alfredzhang98/GripperOne/source_files/imu_JY901P_uart/README.md

# SDK UART user manual

[link](https://wit-motion.yuque.com/wumwnr/ltst03/vl3tpy?)
