alfredzhang98/GripperOne/hardware/bom/BOM.en.md

[中文](BOM.md) | **English**

# Bill of Materials (BOM)

One gripper can be built for about **CNY 3000 (about USD 420)**, of which the PaXini tactile sensors are about CNY 1500. Excel version: [BOM.xlsx](BOM.xlsx); it matches this page, so update both together.

 Lead screw and nut supplier: [Fanzhan Metal Products (繁展金属制品有限公司)](https://shop213748648.taobao.com) on Taobao.

| No. | Category | Name | Image | Spec / Model | Qty | Process / Material | Source / Link | CAD file | Notes |
| --- | --- | --- | --- | --- | --- | --- | --- | --- | --- |
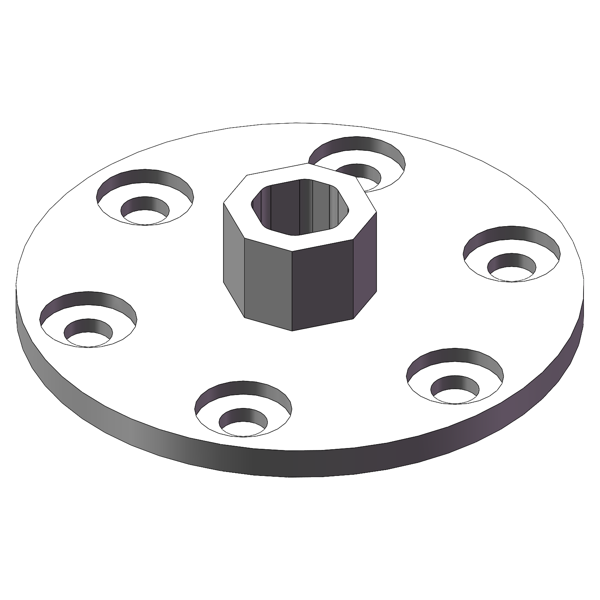
[picture p2: hardware/bom/img/01_rotor_to_lead_screw_coupler.png]
| 1 | Structural parts | Rotor-to-lead-screw coupler |  |  | 1 | CNC | Quanzhou CNC (铨洲) | 转子丝杆传动件 |  |
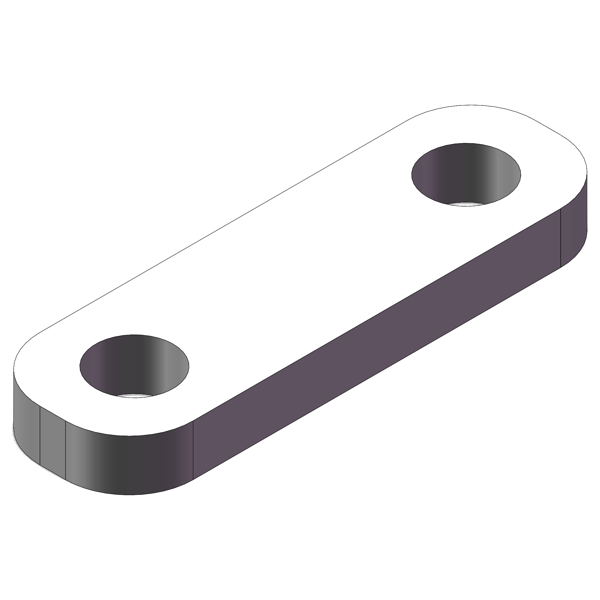
[picture p3: hardware/bom/img/02_nut_link.png]
| 2 | Structural parts | Nut link |  | SS304 | 4 | CNC | Quanzhou CNC (铨洲) | 螺母连杆 | Highly loaded; use SS304 |
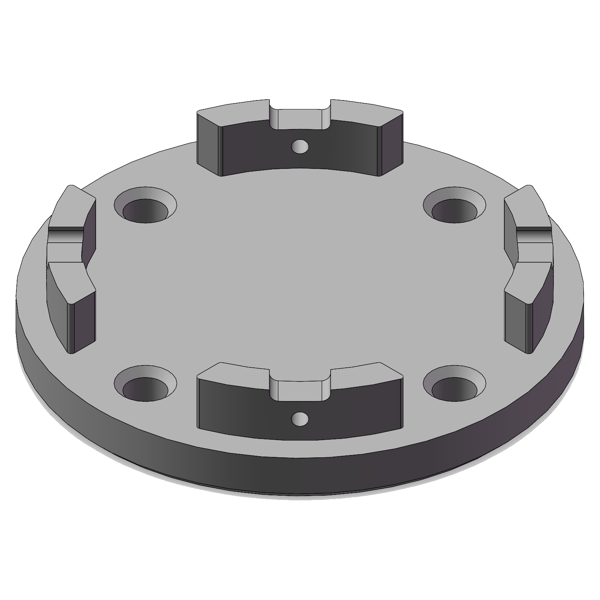
[picture p4: hardware/bom/img/03_bottom_cover.png]
| 3 | Structural parts | Bottom cover |  |  | 1 | 3D print (PETG) |  | urconnector | Avoid resin (SLA) prints: heat-set inserts do not bond well in resin |
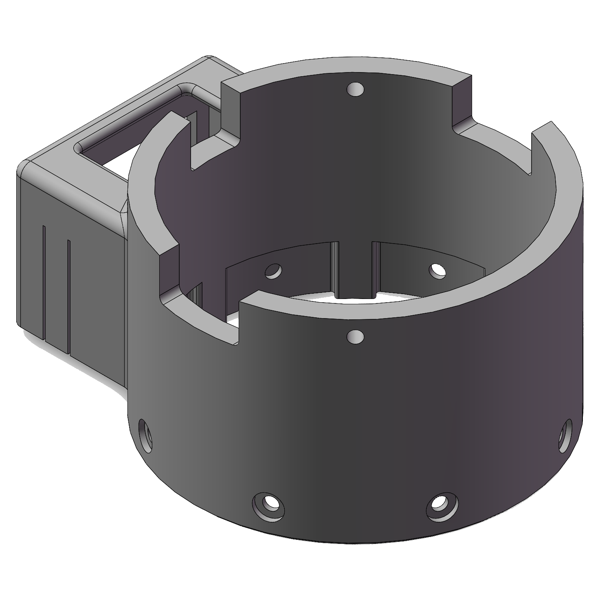
[picture p5: hardware/bom/img/04_motor_housing.png]
| 4 | Structural parts | Motor housing |  |  | 1 | 3D print (PETG) |  | motor_out | Avoid resin (SLA) prints: heat-set inserts do not bond well in resin |
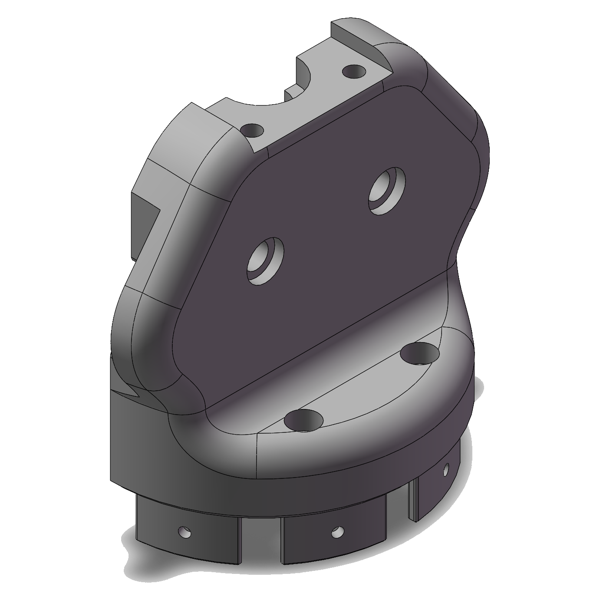
[picture p6: hardware/bom/img/05_main_housing.png]
| 5 | Structural parts | Main housing |  |  | 2 | 3D print (PETG) |  | 外壳 | Avoid resin (SLA) prints: heat-set inserts do not bond well in resin |
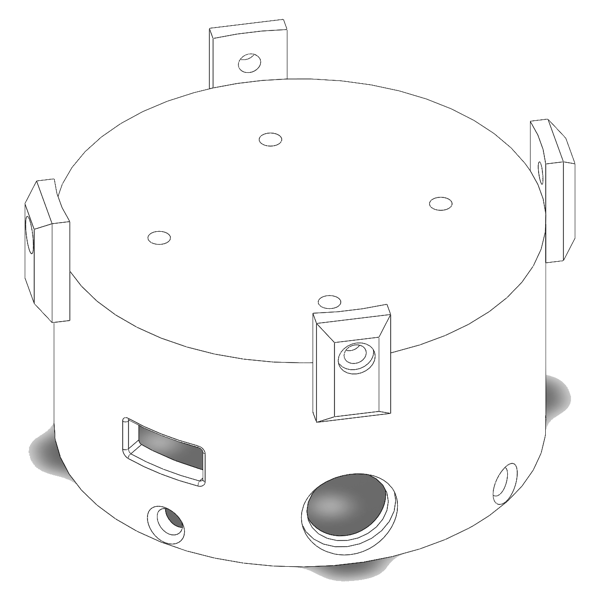
[picture p7: hardware/bom/img/06_electronics_bay_housing.png]
| 6 | Structural parts | Electronics bay housing |  |  | 1 | CNC |  | upper | New in this design: holds the main PCB, side opening for USB |
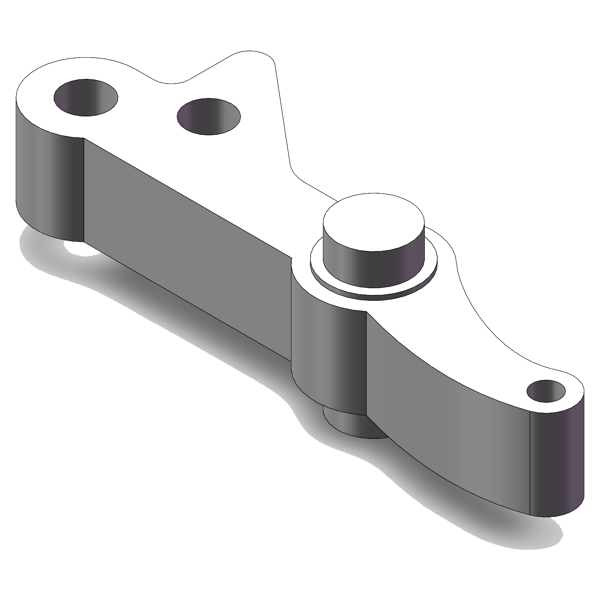
[picture p8: hardware/bom/img/07_driving_link.png]
| 7 | Structural parts | Driving link |  |  | 2 | CNC | Quanzhou CNC (铨洲) | 主动杆 |  |
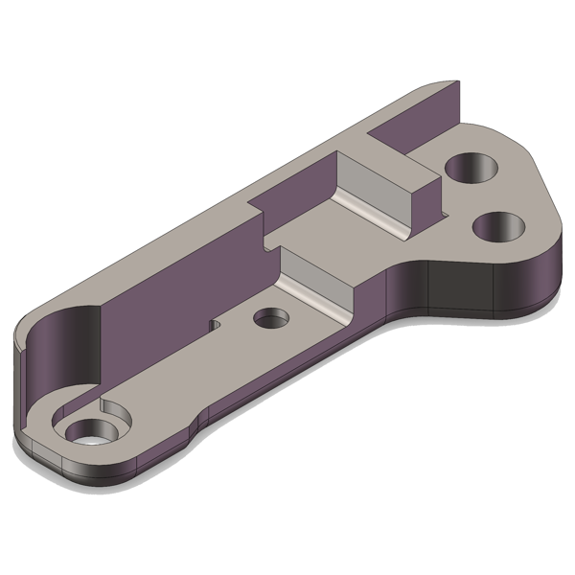
[picture p9: hardware/bom/img/08_underactuated_link.png]
| 8 | Structural parts | Underactuated link |  |  | 2 | CNC | Quanzhou CNC (铨洲) | 镜向欠驱动杆 |  |
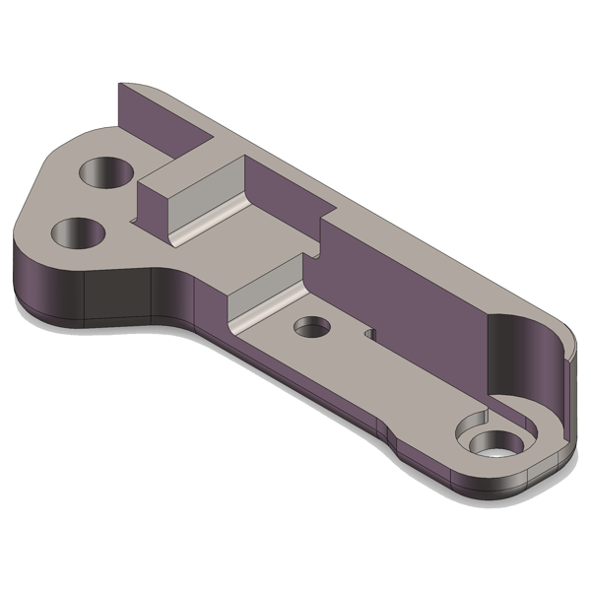
[picture p10: hardware/bom/img/09_underactuated_link_mirrored.png]
| 9 | Structural parts | Underactuated link, mirrored |  |  | 2 | CNC | Quanzhou CNC (铨洲) | 镜向欠驱动杆-镜像 |  |
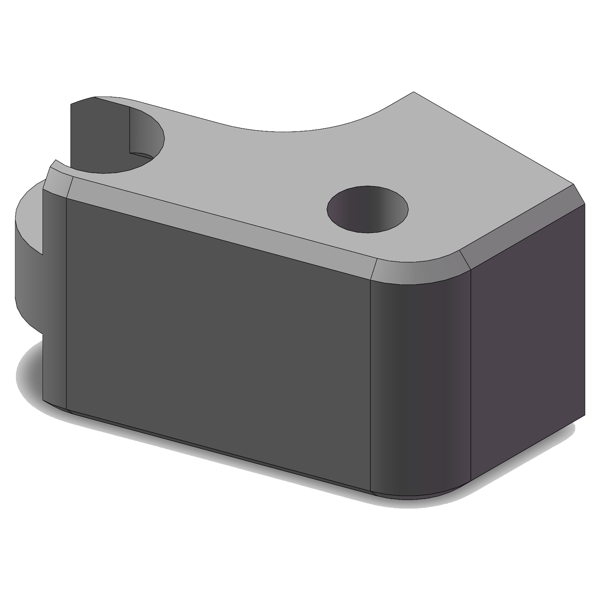
[picture p11: hardware/bom/img/10_finger_link.png]
| 10 | Structural parts | Finger link |  |  | 2 | 3D print (PETG) |  | 手指连杆 | Avoid resin (SLA) prints: heat-set inserts do not bond well in resin |
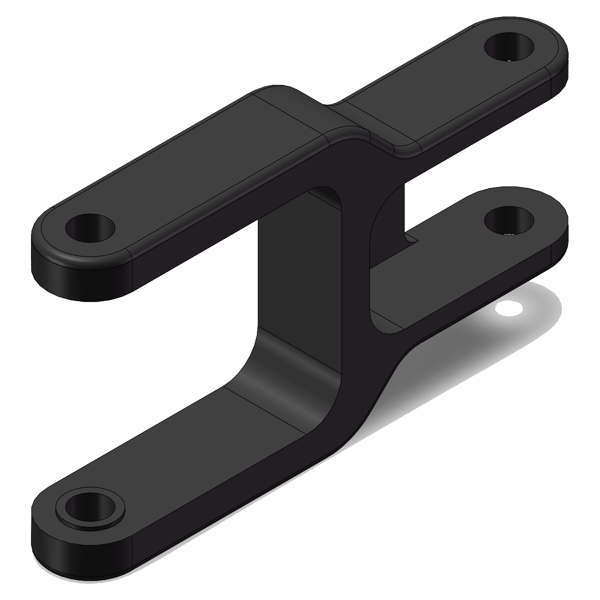
[picture p12: hardware/bom/img/11_driven_link.png]
| 11 | Structural parts | Driven link |  |  | 2 | CNC | Quanzhou CNC (铨洲) | 从动杆 |  |
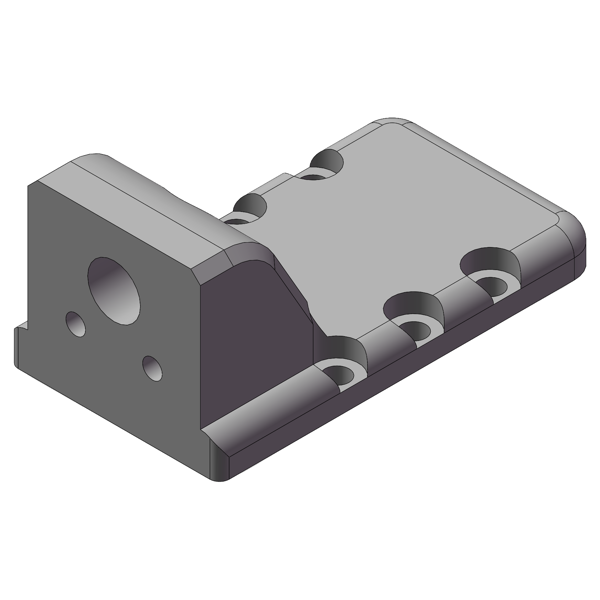
[picture p13: hardware/bom/img/12_finger.png]
| 12 | Structural parts | Finger |  |  | 2 | 3D print (PETG) |  | 手指v2 | Avoid resin (SLA) prints: heat-set inserts do not bond well in resin |
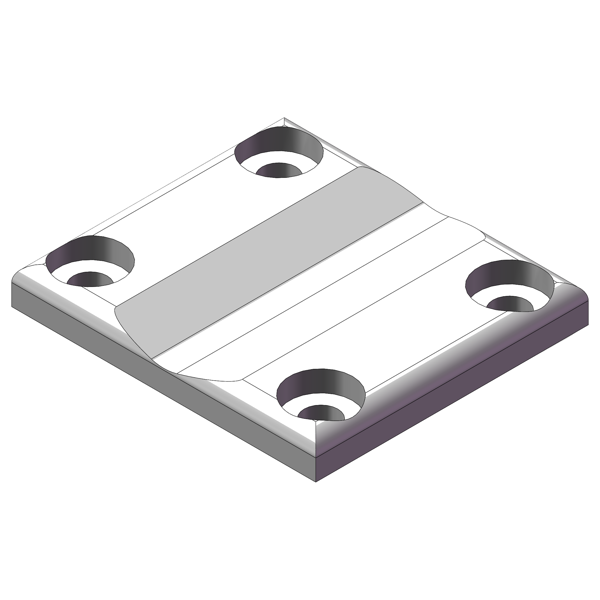
[picture p14: hardware/bom/img/13_end_cap.png]
| 13 | Structural parts | End cap |  |  | 1 | 3D print (PETG) |  | 挡盖 | Avoid resin (SLA) prints: heat-set inserts do not bond well in resin |
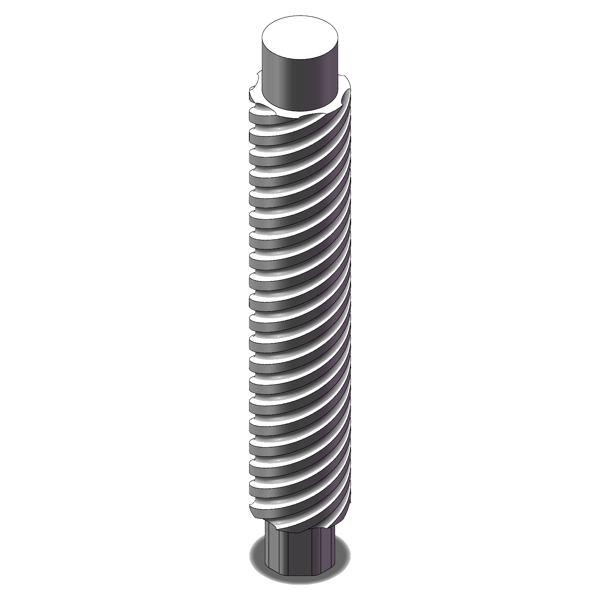
[picture p15: hardware/bom/img/14_lead_screw.png]
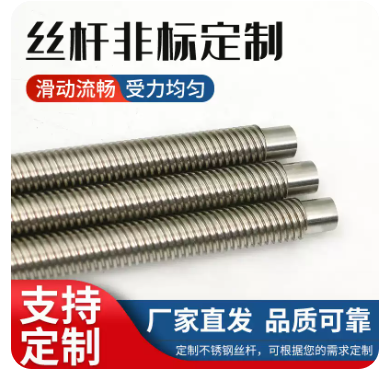
[picture p16: hardware/bom/img/14_lead_screw_shop.png]
| 14 | Drive train | Lead screw |   | SS304 T8×2 trapezoidal screw; the order link's variant shows "left/right-hand T8×2×200 mm + 2 nuts", please verify | 1 | Custom length / end machining | [Fanzhan Metal (Taobao)](https://item.taobao.com/item.htm?id=719659221034&skuId=5016268544734) | 丝杆 | Recommend switching to a standard part, see Suggestions |
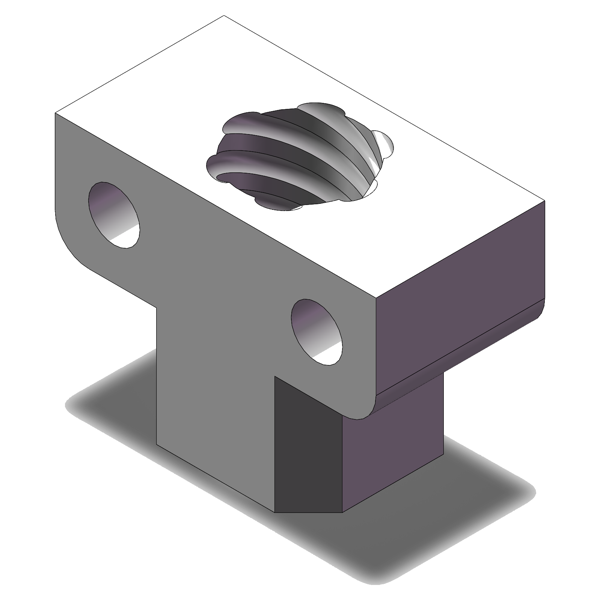
[picture p17: hardware/bom/img/15_lead_screw_nut.png]
| 15 | Drive train | Lead screw nut |  | T8×2 brass nut | 1 | Brass | [Fanzhan Metal (Taobao)](https://item.taobao.com/item.htm?id=719659221034&skuId=5016268544734) | 丝杆螺母 | Same shop as the screw; recommend a standard brass flange nut |
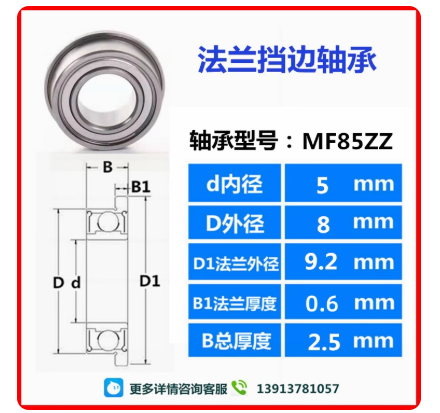
[picture p18: hardware/bom/img/16_small_flanged_bearing.png]
| 16 | Bearings | Small flanged bearing |  | MF85ZZ (5×8×9.2×0.6×2.5) | 4 |  | [Taobao](https://item.taobao.com/item.htm?id=627537372468) |  |  |
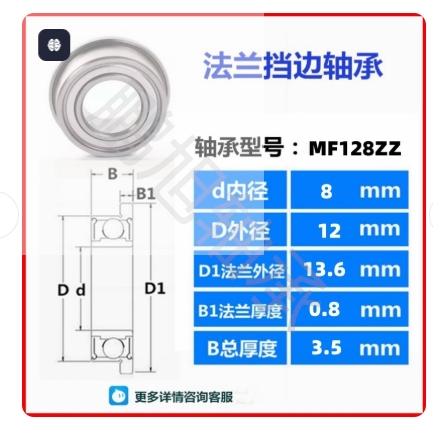
[picture p19: hardware/bom/img/17_flanged_bearing.png]
| 17 | Bearings | Flanged bearing |  | MF128ZZ (8×12×13.6×0.8×3.5) | 4 |  | [Taobao (same shop)](https://item.taobao.com/item.htm?id=627537372468) |  |  |
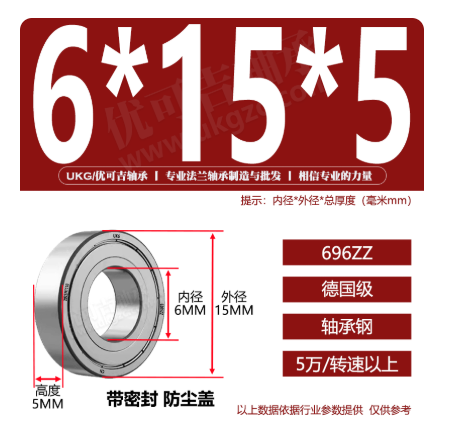
[picture p20: hardware/bom/img/18_deep_groove_ball_bearing.png]
| 18 | Bearings | Deep-groove ball bearing |  | 6×15×5, sealed | 1 |  | [Tmall](https://detail.tmall.com/item.htm?id=735576032715) | 轴承5_15_5 | CAD file says 5×15×5 but BOM says 6×15×5; check the bore |
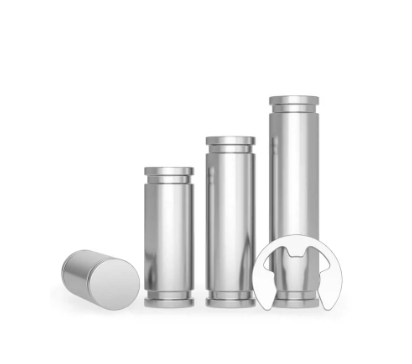
[picture p21: hardware/bom/img/19_grooved_pin_with_circlips.png]
| 19 | Fasteners, pins & springs | Grooved pin with circlips |  | M5×30 (Ø5 × 30 mm) | 6 |  | [Tmall](https://detail.tmall.com/item.htm?id=617648776883&skuId=5533509412784) |  |  |
| 20 | Fasteners, pins & springs | Grooved pin with circlips |  | M5×45 (Ø5 × 45 mm) | 2 |  | [Tmall (same item)](https://detail.tmall.com/item.htm?id=617648776883) | 双头卡簧销轴m5-45 |  |
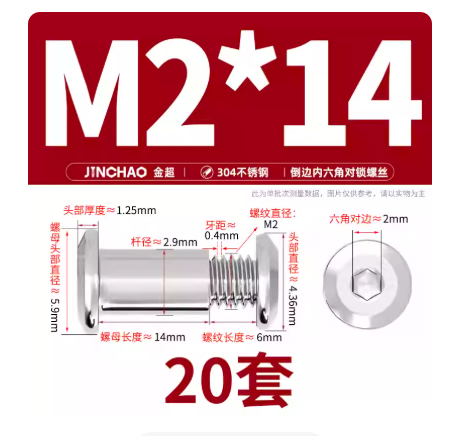
[picture p22: hardware/bom/img/21_binding_screw_chicago_screw.png]
| 21 | Fasteners, pins & springs | Binding screw (Chicago screw) |  | M2×14 | 4 |  | [Tmall](https://detail.tmall.com/item.htm?id=738916254976) |  | Pack of 20 sets |
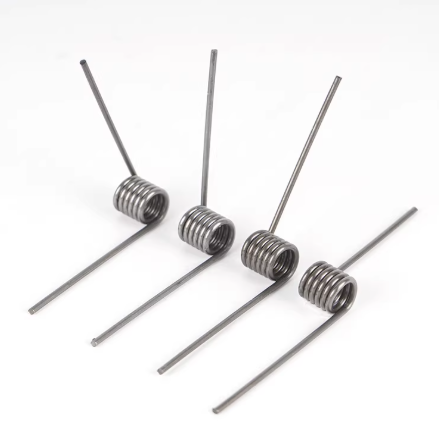
[picture p23: hardware/bom/img/22_torsion_spring.png]
| 22 | Fasteners, pins & springs | Torsion spring |  | Wire 1.2, OD 7.5, 5 coils, 180° | 2 |  | [Tmall](https://detail.tmall.com/item.htm?id=774983364150) |  | 1 left-hand + 1 right-hand (pack of 10) |
| 23 | Fasteners, pins & springs | Socket head cap screw |  | M5×6, ISO 4762 | TBD |  |  |  |  |
| 24 | Fasteners, pins & springs | Socket head cap screw |  | M3×6, ISO 4762 | TBD |  |  |  |  |
| 25 | Fasteners, pins & springs | Socket head cap screw |  | M3×5, ISO 4762 | TBD |  |  |  |  |
| 26 | Fasteners, pins & springs | Low-profile (wafer) head screw |  | M2.5×3 | TBD |  |  |  |  |
| 27 | Fasteners, pins & springs | Socket countersunk screw |  | M3×6, ISO 10642 | TBD |  |  |  |  |
| 28 | Fasteners, pins & springs | Heat-set insert |  | TBD | TBD |  |  |  | Missing from the original BOM, needed by the printed parts |
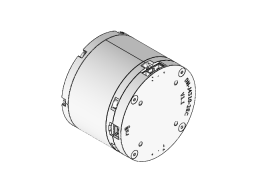
[picture p24: hardware/bom/img/29_joint_motor.png]
| 29 | Actuator | Joint motor |  | Damiao DM-J4310-2EC V1.2, 10:1, 24 V | 1 |  | DAMIAO | DM-J4310-2EC-V1.1_3d | Link TBD |
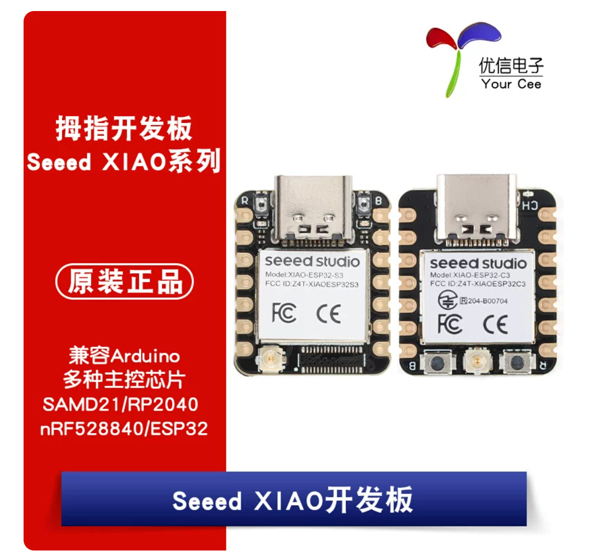
[picture p25: hardware/bom/img/30_controller_board.png]
| 30 | Electronics | Controller board |  | Seeed Studio XIAO ESP32-C6 (PCB Sub1) | 1 |  | [Tmall](https://detail.tmall.com/item.htm?id=779487558268) |  |  |
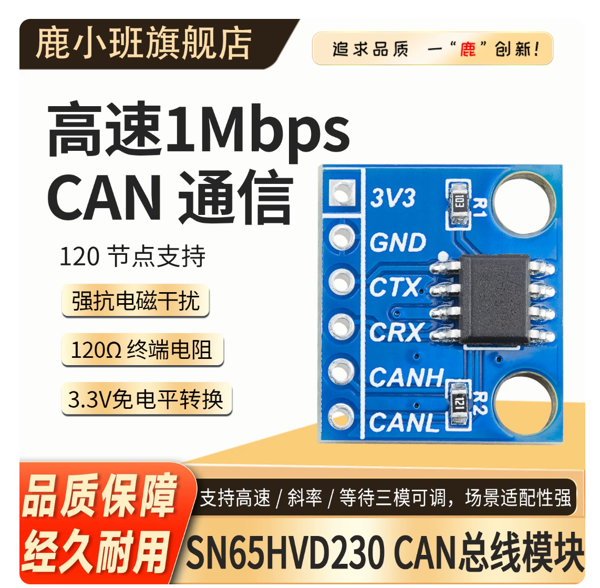
[picture p26: hardware/bom/img/31_can_transceiver_module.png]
| 31 | Electronics | CAN transceiver module |  | 3.3 V, 6-pin 2.54 mm (Sub3) | 1 |  | [Tmall](https://detail.tmall.com/item.htm?id=1026039679688&skuId=6203293530777) |  | ESP32-C6 has the TWAI controller only; a transceiver is required |
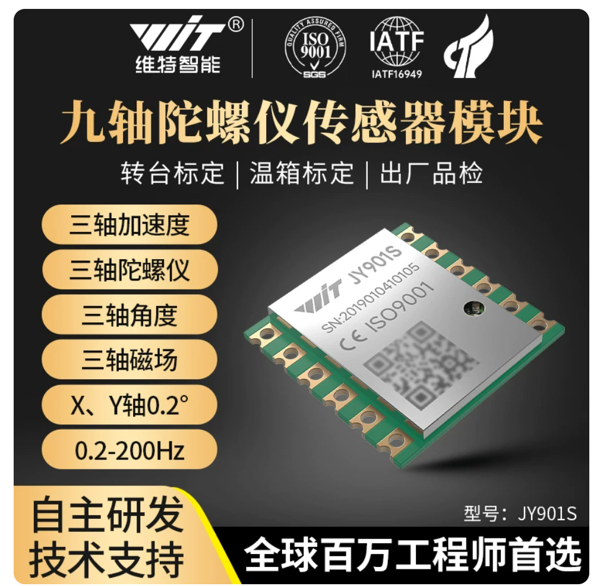
[picture p27: hardware/bom/img/32_imu.png]
| 32 | Electronics | IMU |  | WitMotion JY901P (Sub2) | 1 |  | [Taobao](https://item.taobao.com/item.htm?id=995918759607) |  |  |
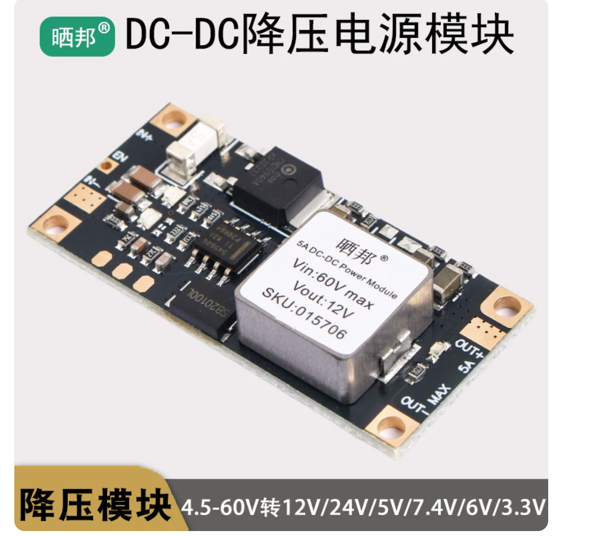
[picture p28: hardware/bom/img/33_24_v_5_v_dc_dc_module.png]
| 33 | Electronics | 24 V→5 V DC-DC module |  | PCB P1 | 1 |  | [Taobao](https://item.taobao.com/item.htm?id=908768946162) |  | Never together with XIAO USB power; leave unsoldered during development |
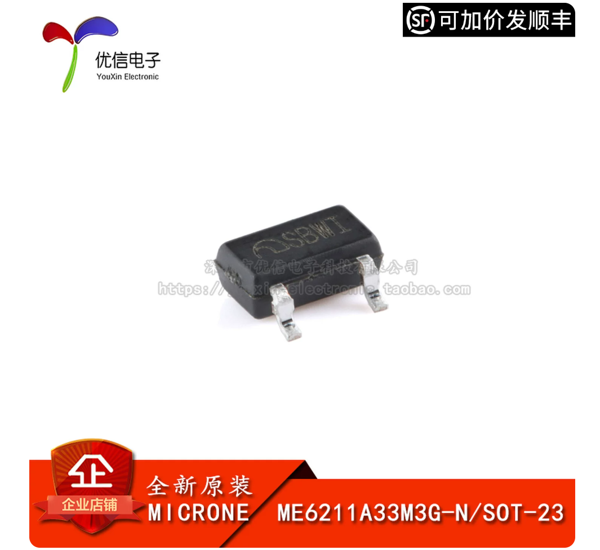
[picture p29: hardware/bom/img/34_ldo_regulator.png]
| 34 | Electronics | LDO regulator |  | ME6211A33M3G-N, 3.3 V, SOT-23 (IC1) | 1 |  | [Taobao](https://item.taobao.com/item.htm?id=823005831436) |  |  |
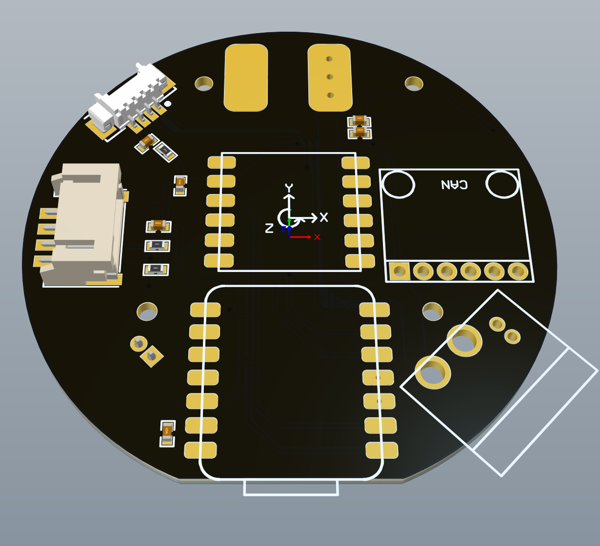
[picture p30: hardware/bom/img/35_main_pcb.png]
| 35 | Electronics | Main PCB |  | 2-layer, production files in hardware/pcb/production.zip | 1 | PCB fab (e.g. JLCPCB) |  | gripper_arm_BOARD | Passives: see the PCB parts sheet / table |
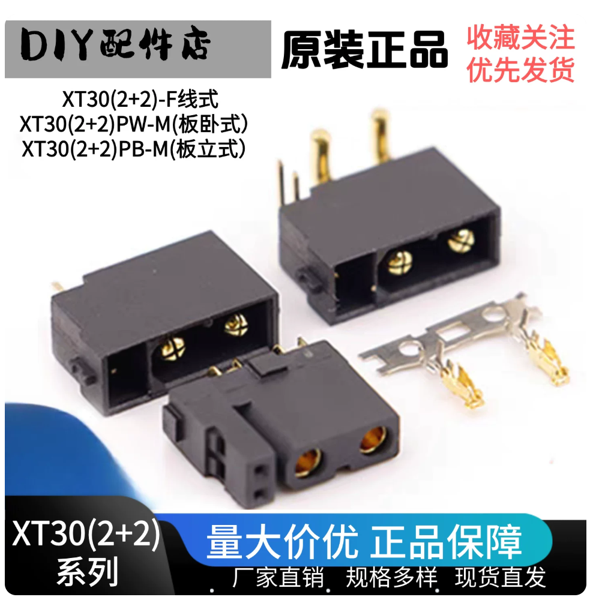
[picture p31: hardware/bom/img/36_xt30_2_2_socket.png]
| 36 | Electronics | XT30(2+2) socket |  | Motor power + CAN (Con2) | 1 |  | [Taobao](https://item.taobao.com/item.htm?id=892794165229) |  |  |
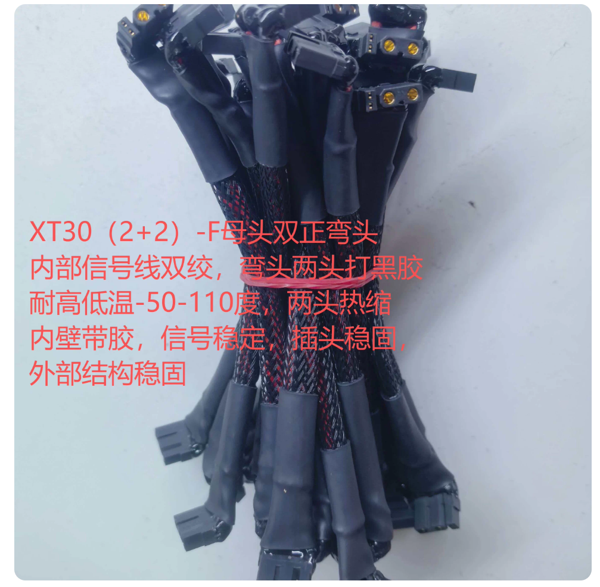
[picture p32: hardware/bom/img/37_xt30_2_2_motor_cable.png]
| 37 | Electronics | XT30(2+2) motor cable |  | Mates Con2, to the DM-J4310 | 1 |  | [Taobao](https://item.taobao.com/item.htm?id=1043911293012) |  |  |
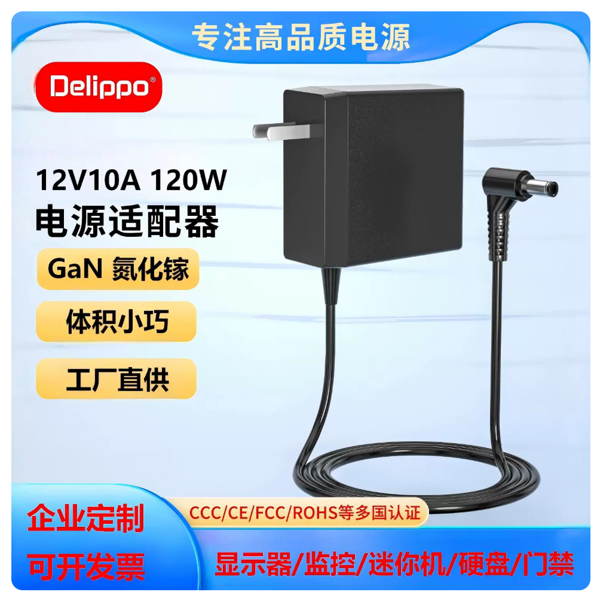
[picture p33: hardware/bom/img/38_24_v_dc_power_adapter.png]
| 38 | Electronics | 24 V DC power adapter |  | 24 V, DELIPPO GaN adapter (listing photo shows the 12 V model; order the 24 V variant) | 1 |  | [Taobao](https://item.taobao.com/item.htm?id=900740020964) |  | Powers the motor and the PCB |
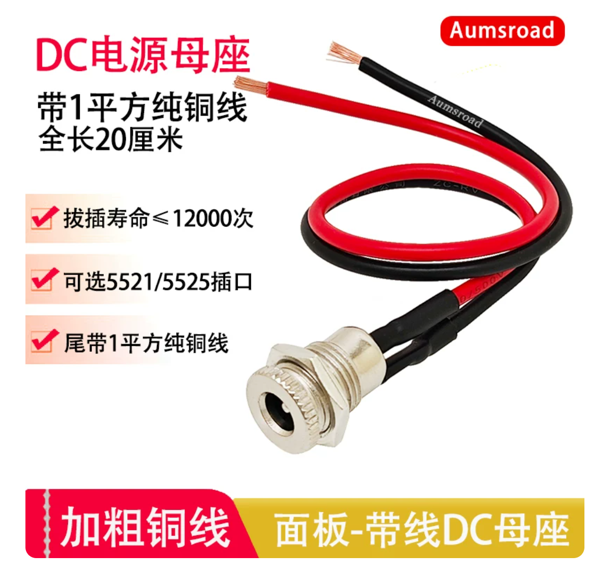
[picture p34: hardware/bom/img/39_24_v_supply_lead.png]
| 39 | Electronics | 24 V supply lead |  | Soldered to the PCB 24 V input pads (Con1) | 1 |  | [Tmall](https://detail.tmall.com/item.htm?id=927221788917) |  |  |
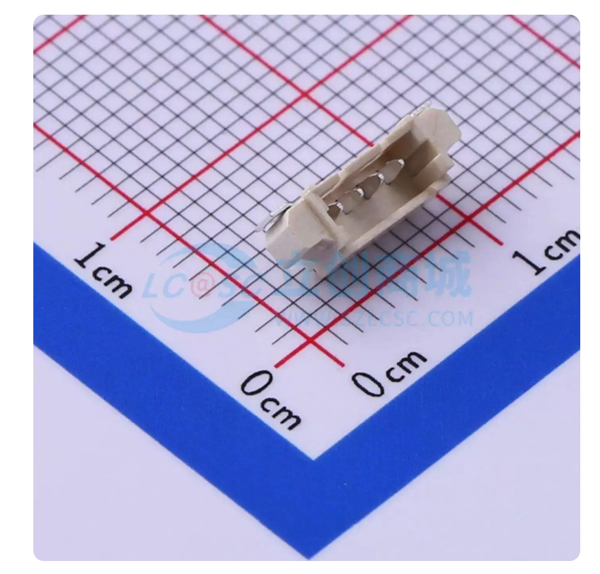
[picture p35: hardware/bom/img/40_mx1_25_4p_horizontal_smd_header.png]
| 40 | Electronics | MX1.25 4P horizontal SMD header |  | PCB → tactile board (connect in1) | 1 |  | [Taobao](https://item.taobao.com/item.htm?id=1011820309391) |  |  |
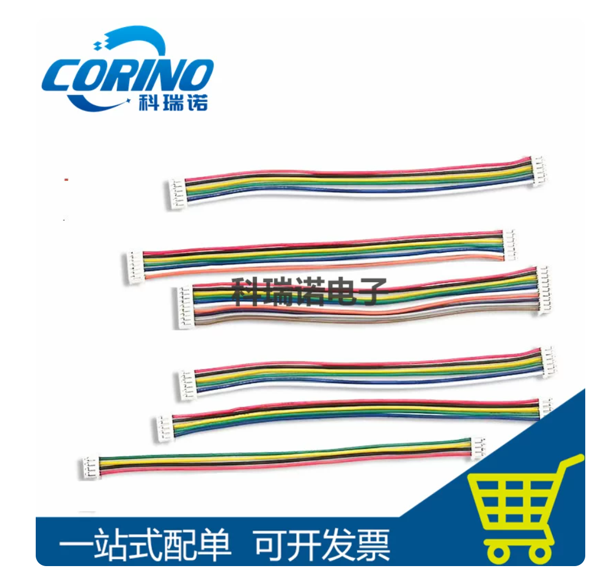
[picture p36: hardware/bom/img/41_mx1_25_4p_cable.png]
| 41 | Electronics | MX1.25 4P cable |  | PCB ↔ tactile board UART | 1 |  | [Taobao](https://item.taobao.com/item.htm?id=1037011788971) |  | Same-direction and reversed versions exist; check WIRING section 3 before buying |
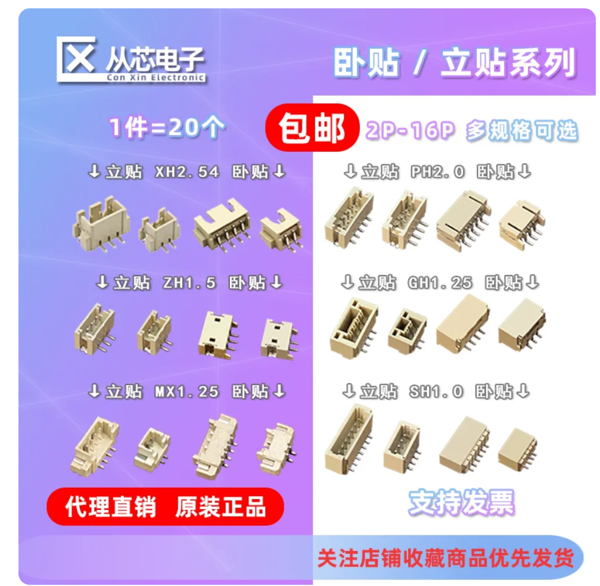
[picture p37: hardware/bom/img/42_ph2_0_4p_horizontal_smd_header.png]
| 42 | Electronics | PH2.0 4P horizontal SMD header |  | External display (OLED1); must be PH2.0 | 1 |  | [Taobao](https://item.taobao.com/item.htm?id=849667026616) |  | Optional |
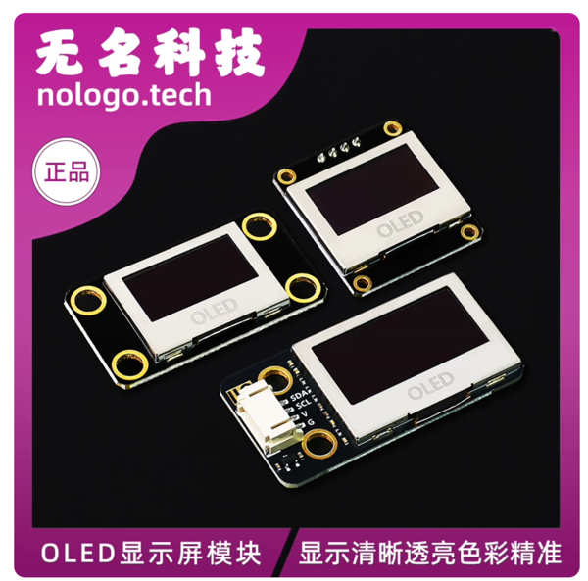
[picture p38: hardware/bom/img/43_1_3_inch_oled_display.png]
| 43 | Electronics | 1.3 inch OLED display |  | SH1106, I2C | 1 |  | [Taobao](https://item.taobao.com/item.htm?id=678589112969) |  | Optional; not driven by the current firmware |
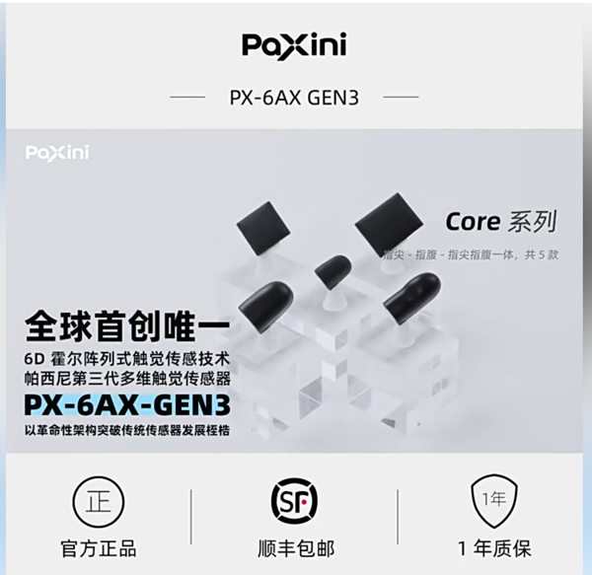
[picture p39: hardware/bom/img/44_tactile_finger_pad.png]
| 44 | Electronics | Tactile finger pad |  | PaXini PX6AX-GEN3-CP-M3025-Core | 2 |  | [Tmall](https://detail.tmall.com/item.htm?id=961726831317&skuId=6078300404563) | Finger pad 指腹 M3025 | PaXini now offers a gripper-specific GEN4 that can replace it (firmware implements the GEN3 protocol; verify before switching) |
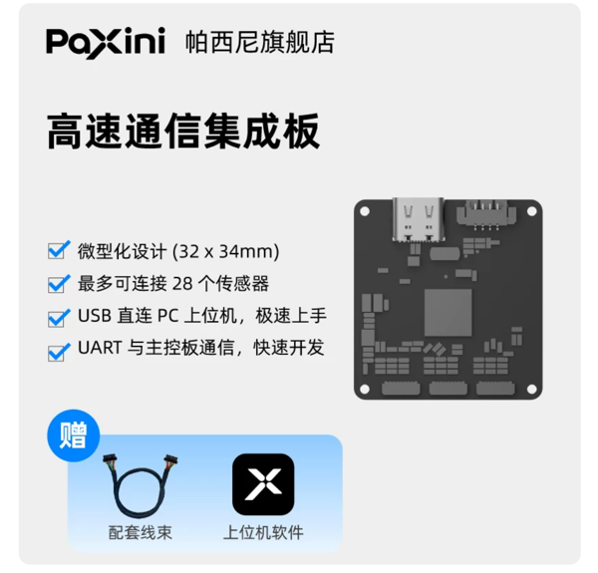
[picture p40: hardware/bom/img/45_tactile_high_speed_communication_board.png]
| 45 | Electronics | Tactile high-speed communication board |  | PaXini PX-6AX GEN3 | 1 |  | [Tmall](https://detail.tmall.com/item.htm?id=961726831317&skuId=6243788931561) |  | Needs a 4.5–5 V supply, not 3V3 |
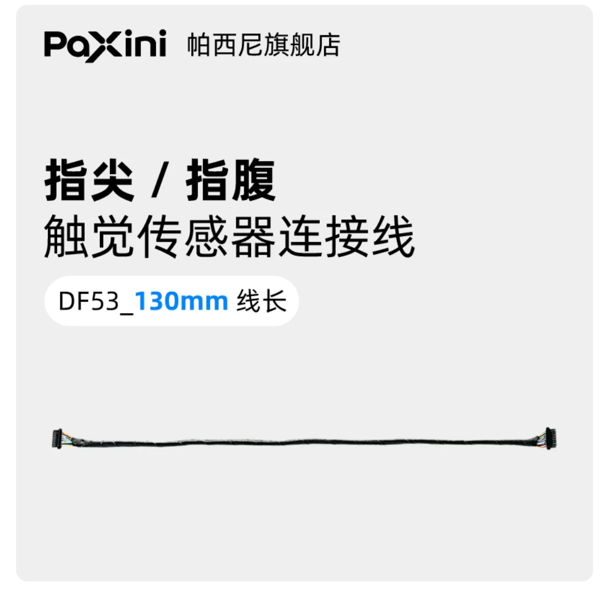
[picture p41: hardware/bom/img/46_tactile_sensor_extension_cable.png]
| 46 | Electronics | Tactile sensor extension cable |  | Sensor ↔ integration board | 2 |  | [Tmall](https://detail.tmall.com/item.htm?id=965246600488&skuId=6243521550639) |  | Stock cable is too short; required, one per sensor |

## PCB parts

From the Altium export `bom_electrical.xlsx` in [`../pcb/production.zip`](../pcb/production.zip). Passives can be sourced through JLCPCB SMT assembly or LCSC.

| Comment | Designator | Footprint | LibRef | Qty |
| --- | --- | --- | --- | --- |
| 0.1uf | C1, C2, C5, C6 | C 0603_L | C | 4 |
| 1uF | C3 | C 0603_L | C | 1 |
| 10uf | C4 | C 0603_L | C | 1 |
| 1uF | C8, C11 | C0402_L | C | 2 |
| 10uF | C9 | C0402_L | C | 1 |
| 100nF | C10 | C0402_L | C | 1 |
| 24v_input_pad | Con1 | high volt input | 24v_input_pad | 1 |
| xt30_2_2 | Con2 | xt30_2_2 | xt30_2_2 | 1 |
| HDR-1X4 | connect in1 | MX 1.25-WS-4P | Header 4 | 1 |
| ME6211A33M3G-N | IC1 | SOT95P280X145-3N | ME6211A33M3G-N | 1 |
| HDR-1X2 | JP1 | PH2.0-WI-2P | Header 2 | 1 |
| HDR-1X4 | OLED1 | PH2.0-WS-4P | Header 4 | 1 |
| DC_module | P1 | xibang_24v_dc | DC_module | 1 |
| 4.7k | R1, R2 | R 0603_L | R | 2 |
| 0(NC) | R3 | R 0603_L | R | 1 |
| esp32_c6_xiao | Sub1 | esp32_c6_xiao | esp32_c6_xiao | 1 |
| JY901x | Sub2 | JY901x | JY901x | 1 |
| can_twai | Sub3 | 6pin_2.5_can | can_twai | 1 |

The CAD file column gives the `<name>` part of `hardware/cad/gripper_<name>_v1.SLDPRT`.

## Suggestions

1. **Switch the lead screw and nut to standard parts**: The thread is already a standard T8×2; only the length and end are custom. Redesign the screw length and end to match a stock variant (standard length, plain shaft end) and use a standard brass flange nut, so both can be ordered off the shelf with no custom machining.
2. **Add fastener quantities and buy by standard number**: The original BOM lists fasteners without quantities. Count them from the assembly and order by standard number (ISO 4762 / GB/T 70.1 cap screws, ISO 10642 / GB/T 70.3 countersunk) so any supplier can fill the order.
3. **Complete the electronics**: The original BOM had mechanical parts only. Controller, CAN transceiver, tactile sensors, integration board, IMU, the PCB and its components, connectors and cables are now listed with purchase links.
4. **Strip tracking parameters from links**: The original links carried personal order-history parameters (mi_id, spm, ...). Only the item id and variant skuId are kept.
