alfredzhang98/GripperOne/(list of files, cad)

Other CAD files:
hardware/cad/gripper_Layer_ViaTop Layer-Bottom Layer_gripper_arm.SLDASM_v1.SLDPRT
hardware/cad/gripper_Layer_Interlayer_gripper_arm.SLDASM_v1.SLDASM
hardware/cad/gripper_bottom_circuits_v1.SLDASM
hardware/cad/gripper_gripper_arm_v1.SLDASM
hardware/cad/gripper_DM-J4310-2EC-V1.1_3d_20260228_1_v1.SLDASM
hardware/cad/gripper_Top Layer_gripper_arm.SLDASM_2_v1.SLDPRT
hardware/cad/gripper_Layer_Top Layer_gripper_arm.SLDASM_v1.SLDASM
hardware/cad/gripper_Layer_Bottom Layer_gripper_arm.SLDASM_v1.SLDASM
hardware/cad/gripper_Interlayer_gripper_arm.SLDASM_v1.SLDPRT
hardware/cad/gripper_full_structure_v1.SLDASM
hardware/cad/gripper_Bottom Layer_gripper_arm.SLDASM_2_v1.SLDPRT
hardware/cad/gripper_Bottom SolderMask_gripper_arm.SLDASM_0_v1.SLDPRT
hardware/cad/gripper_Bottom Layer_gripper_arm.SLDASM_0_v1.SLDPRT
hardware/cad/gripper_Layer_Top SolderMask_gripper_arm.SLDASM_v1.SLDASM
hardware/cad/gripper_tip1_v1.SLDASM
hardware/cad/gripper_Top Layer_gripper_arm.SLDASM_0_v1.SLDPRT
hardware/cad/gripper_Top Layer_gripper_arm.SLDASM_3_v1.SLDPRT
hardware/cad/gripper_Layer_Bottom SolderMask_gripper_arm.SLDASM_v1.SLDASM
hardware/cad/gripper_Top Layer_gripper_arm.SLDASM_1_v1.SLDPRT
hardware/cad/gripper_RhinoV2.0_Assembly_v1.SLDASM
hardware/cad/gripper_Top SolderMask_gripper_arm.SLDASM_0_v1.SLDPRT
hardware/cad/gripper_Bottom Layer_gripper_arm.SLDASM_3_v1.SLDPRT
hardware/cad/gripper_Top Layer_gripper_arm.SLDASM_4_v1.SLDPRT
hardware/cad/gripper_Bottom Layer_gripper_arm.SLDASM_1_v1.SLDPRT
hardware/cad/gripper_镜向欠驱动杆-镜像_v1.SLDPRT
hardware/cad/gripper_PH2.0-WI-2P_Header_2-1_v1.SLDPRT
hardware/cad/gripper_从动杆_v1.SLDPRT
hardware/cad/gripper_双头卡簧销轴m5-45_v1.SLDPRT
hardware/cad/gripper_R_0603_L_R-1_v1.SLDPRT
hardware/cad/gripper_upper_v1.SLDPRT
hardware/cad/gripper_外壳_v1.SLDPRT
hardware/cad/gripper_挡盖_v1.SLDPRT
hardware/cad/gripper_C_0603_L_C-1_v1.SLDPRT
hardware/cad/gripper_C0402_L_C-7_v1.SLDPRT
hardware/cad/gripper_螺母连杆_v1.SLDPRT
hardware/cad/gripper_Finger pad 指腹 M3025 PX6AX-GEN3-CP-M3025-Core PXSR-STDCP03B_v1.stp
hardware/cad/gripper_手指v2_v1.SLDPRT
hardware/cad/gripper_MX_1.25-WS-4P_Header_4-1_v1.SLDPRT
hardware/cad/gripper_欠驱动杆-镜像_v1.SLDPRT
hardware/cad/gripper_丝杆_v1.SLDPRT
hardware/cad/gripper_gripper_arm_BOARD_v1.SLDPRT
hardware/cad/gripper_主动杆_v1.SLDPRT
hardware/cad/gripper_轴承5_15_5_v1.SLDPRT
hardware/cad/gripper_SOT95P280X145-3N_ME6211A33M3G-N-1_v1.SLDPRT
hardware/cad/gripper_镜向欠驱动杆_v1.SLDPRT
hardware/cad/gripper_urconnector_v1.SLDPRT
hardware/cad/gripper_转子丝杆传动件_v1.SLDPRT
hardware/cad/gripper_手指连杆_v1.SLDPRT
hardware/cad/gripper_motor_out_v1.SLDPRT
hardware/cad/gripper_欠驱动杆_v1.SLDPRT
hardware/cad/gripper_PH2.0-WS-4P_Header_4-1_v1.SLDPRT
hardware/cad/gripper_丝杆螺母_v1.SLDPRT
hardware/cad/gripper_Finger pad 指腹 M3025 PX6AX-GEN3-CP-M3025-Core PXSR-STDCP03B_v1.SLDPRT
