alfredzhang98/GripperOne/(list of files, drawings)

Other design files:
hardware/pcb/gripper_control.PcbDoc
hardware/pcb/gripper_control.SchDoc
