alfredzhang98/GripperOne/host/point_map_m3025.py

# Physical position of each of the 77 measurement points, in millimetres,
# from the vendor sheet "Finger pad 指腹 M3025 PX6AX-GEN3-CP-M3025-Core
# PXSR-STDCP03B.xlsx" (kept in firmware/components/haptic_uart/ref/). Index order here
# is the wire order: point 1 is the first (Fx, Fy, Fz) triple in the block
# read from the board, point 77 the last.
#
# The pad is NOT a 7x11 rectangle. It is a curved fingertip surface of nine
# columns - the two outer ones carry 7 points, the seven inner ones 9 each -
# spanning 25.3 mm across, 30.6 mm along, with Z bulging from 2.70 mm at the
# rim to 6.05 mm at the crown. Index order is not a raster scan either: within
# a column the point numbers do not follow Y monotonically. Drawing these as a
# regular grid is what made pressed positions land in the wrong place.
POINT_XYZ_MM = [
    (-12.650, -0.625,2.700), (-12.650,  4.454,2.700), (-12.650,  9.532,2.700), (-12.650, 14.610,2.700),
    (-12.650, 18.843,2.700), (-12.650, 23.921,2.700), (-12.650, 29.000,2.700), ( -9.469,  1.076,5.326),
    ( -9.469, -1.108,2.701), ( -9.469,  5.572,5.326), ( -9.469, 10.067,5.326), ( -9.469, 14.563,5.326),
    ( -9.469, 18.309,5.326), ( -9.469, 22.804,5.326), ( -9.469, 27.299,5.326), ( -9.469, 29.482,2.701),
    ( -6.313, -1.108,2.701), ( -6.342,  1.401,5.775), ( -6.342,  5.784,5.775), ( -6.342, 10.169,5.775),
    ( -6.342, 13.823,5.775), ( -6.342, 18.208,5.775), ( -6.342, 22.592,5.775), ( -6.342, 26.976,5.775),
    ( -6.313, 29.482,2.701), ( -3.156, -1.108,2.701), ( -3.176,  1.558,5.992), ( -3.177,  5.888,5.992),
    ( -3.177, 10.218,5.992), ( -3.177, 13.827,5.992), ( -3.176, 18.158,5.992), ( -3.176, 22.489,5.992),
    ( -3.176, 26.819,5.992), ( -3.156, 29.482,2.701), (  0.000, -1.108,2.701), (  0.000,  1.602,6.053),
    (  0.000,  5.917,6.053), (  0.000, 10.232,6.053), (  0.000, 13.828,6.053), (  0.000, 18.144,6.053),
    (  0.000, 22.459,6.053), (  0.000, 26.774,6.053), (  0.000, 29.482,2.701), (  3.156, -1.108,2.701),
    (  3.176,  1.558,5.992), (  3.177,  5.888,5.992), (  3.177, 10.218,5.992), (  3.177, 13.827,5.992),
    (  3.176, 18.158,5.992), (  3.176, 22.489,5.992), (  3.176, 26.819,5.992), (  3.156, 29.482,2.701),
    (  6.313, -1.108,2.701), (  6.342, 13.823,5.775), (  6.342, 18.208,5.775), (  6.342, 22.592,5.775),
    (  6.342, 26.976,5.775), (  6.313, 29.482,2.701), (  6.342,  1.401,5.775), (  6.342,  5.784,5.775),
    (  6.342, 10.169,5.775), (  9.469, -1.108,2.701), (  9.469, 27.299,5.326), (  9.469, 29.482,2.701),
    (  9.469,  1.076,5.326), (  9.469,  5.572,5.326), (  9.469, 10.067,5.326), (  9.469, 14.563,5.326),
    (  9.469, 18.309,5.326), (  9.469, 22.804,5.326), ( 12.650,  4.454,2.700), ( 12.650,  9.532,2.700),
    ( 12.650, 14.610,2.700), ( 12.650, 18.843,2.700), ( 12.650, 23.921,2.700), ( 12.650, 29.000,2.700),
    ( 12.650, -0.625,2.700),
]
