alfredzhang98/GripperOne/host/4_gripper_gui.py

#!/usr/bin/env python3
"""PySide6 control panel for the gripper: one-click operations and live data.

Connects over USB, Bluetooth LE or Wi-Fi (TCP) with the same links as
host/3_gripper_cli.py. The firmware pushes state, position, motor and both
pads (GRIP_STREAM_EN: 30 Hz over Bluetooth, 50 Hz otherwise); older firmware
is polled up to 20 times a second instead. Plots the last 20 s as the data
arrives and exports what it recorded to CSV.

    python host/4_gripper_gui.py
    python host/4_gripper_gui.py --render tmp/gripper_gui.png   # offscreen screenshot with demo data

Esc = motor off at once (MOTOR_DISABLE), on any link.
"""

import argparse
import csv
import importlib.util
import math
import os
import pathlib
import queue
import struct
import sys
import threading
import time
from collections import deque

HERE = pathlib.Path(__file__).resolve().parent
_spec = importlib.util.spec_from_file_location("gripper_cli", HERE / "3_gripper_cli.py")
cli = importlib.util.module_from_spec(_spec)
_spec.loader.exec_module(cli)

# The firmware pushes state, both pads and the motor (GRIP_STREAM_EN) at a
# display rate; its own force control runs on every tactile sample regardless.
STREAM_HZ = {"ble": 30, "usb": 50, "tcp": 50}
CALIB_S = 1.0         # with the stream: GRIP_GET_CALIB this often, for the calibration
                      # values and as the keepalive (the stream stops after 3 s silence)
# Older firmware without the stream is polled instead:
POLL_S = 0.05         # a round of state + motor + pads requests at most this often ...
ROUND_TIMEOUT_S = 0.5 # ... and only once the last round answered (or this passed)
STALE_S = 1.0         # no motor reply this long: shown as no feedback
HISTORY_S = 20.0      # plotted window
GAP_S = 0.6           # a plotted line breaks only where samples are further apart
REDRAW_MS = 30        # plots scroll with the clock, not only when data arrives
LIVE_MIN_S = 0.05     # dragged slider: at most one move command per this, one in flight
RECORD_MAX = 120000   # rows kept for CSV export (100 min at 20 Hz)
# home and calibration run for a long time after their OK; pressing either again restarts from the beginning
CAL_OPS = {"GRIP_HOME": "home 约 40 s（没有存储的标定时自动改做完整标定，约 1.5–3 分钟）",
           "GRIP_CALIBRATE": "完整标定约 1.5–3 分钟"}
CAL_REFUSAL_NEXT = "（拒绝原因见下一行）"   # home / calibration refused: the next poll names the fault


# link worker -----------------------------------------------------------------

def nice_axis(lo, hi, n=4):
    """Axis from lo to hi in about n steps of 1, 2, 2.5 or 5 x 10^k: (lo, hi, step)."""
    raw = max(hi - lo, 1e-6) / n
    mag = 10.0 ** math.floor(math.log10(raw))
    step = next(m * mag for m in (1, 2, 2.5, 5, 10) if m * mag >= raw * 0.999)
    return math.floor(lo / step + 1e-9) * step, math.ceil(hi / step - 1e-9) * step, step


class GuiLink(cli.Link):
    """cli.Link that hands firmware log lines and every status reply to the GUI
    the moment they are parsed, each with its own arrival time."""

    def __init__(self, io, events):
        super().__init__(io)
        self.events = events
        self.round_open = False   # a poll round still waits for its last reply
        self.tele_state = None    # gripper state in the last stream frame
        self.calib_wanted = False # calibration just ended: fetch its values now

    def _frame(self, ftype: int, seq: int, pl: bytes):
        if pl and pl[0] == cli.OP["GRIP_STREAM_EN"] and ftype == cli.T_TELEMETRY and len(pl) >= 48:
            self._tele(pl)
            return
        calib, motor = self.calib, self.motor
        super()._frame(ftype, seq, pl)
        t = time.time()
        if self.calib is not calib:
            self.events.put(("calib", t, self.calib, True))
        if self.motor is not motor:
            self.events.put(("motor", t, self.motor))
        if pl and pl[0] == cli.OP["HAPTIC_GET"]:
            if ftype in (cli.T_ACK, cli.T_ERROR):
                self.round_open = False          # tactile refused: the round is over
            elif len(pl) >= 25:
                self.events.put(("pad", t, pl[1], self.pads[pl[1]]))
                if pl[1] == 1:                   # the little pad answers last
                    self.round_open = False

    def _tele(self, pl: bytes):
        """One GRIP_STREAM_EN frame (emit_grip_tele() in the firmware) becomes the
        usual calib / motor / pad events. The calibration values in "calib" are
        those of the last GRIP_GET_CALIB reply, marked as not a full reply."""
        t = time.time()
        state, fault, flags, err = pl[1], pl[2], pl[3], pl[4]
        pos, opening, ftarget, ring, little, torque, vel, t_mos, t_rotor = struct.unpack_from("<9f", pl, 12)
        if self.tele_state == cli.GRIP_STATE.index("CALIBRATING") and state != self.tele_state:
            self.calib_wanted = True
        self.tele_state = state
        if self.calib is not None:
            c = dict(self.calib, valid=flags & 0x01, state=state, fault=fault, pos=pos, opening=opening,
                     force_target=ftarget)
            self.events.put(("calib", t, c, False))
        if flags & 0x04:   # motor feedback fresh
            self.events.put(("motor", t, {"enabled": (flags >> 1) & 1, "pos": pos, "vel": vel, "torque": torque,
                                          "t_mos": t_mos, "t_rotor": t_rotor, "err": err, "t": t}))
        for index, fz in ((0, ring), (1, little)):
            if flags & (0x08 << index):   # that pad fresh
                self.events.put(("pad", t, index, fz))

    def _log(self, raw: bytes):
        for line in cli.ANSI.sub(b"", raw).decode("utf-8", "replace").splitlines():
            line = line.rstrip()
            if line:
                self.events.put(("log", line))


class Worker(threading.Thread):
    """Owns the link. The GUI sends ("connect"|"disconnect"|"op", ...) on cmd_q;
    the worker answers with events on the GUI's queue."""

    def __init__(self, events: queue.Queue):
        super().__init__(daemon=True)
        self.events = events
        self.cmd_q = queue.Queue()
        self.link = None
        self.stream = False   # the firmware accepted GRIP_STREAM_EN on this link
        self.next_poll = 0.0
        self.next_calib = 0.0
        self.round_t = 0.0

    def run(self):
        while True:
            try:
                item = self.cmd_q.get(timeout=0.005 if self.link else 0.05)
            except queue.Empty:
                item = None
            try:
                if item:
                    self._handle(item)
                if self.link:
                    self.link.poll()   # one read (at most ~20 ms); replies go to the GUI as parsed
                    self._request()
            except (OSError, ConnectionError) as e:
                self._drop("connection lost: %s" % e)

    def _drop(self, why, stop_stream=False):
        if self.link:
            try:
                if stop_stream and self.stream:   # USB has no close event the firmware could see
                    self.link.send(cli.OP["GRIP_STREAM_DIS"])
                self.link.ser.close()
            except Exception:
                pass
        self.link = None
        self.stream = False
        self.events.put(("disconnected", why))

    def _handle(self, item):
        kind = item[0]
        if kind == "connect":
            _, link_kind, target = item
            if self.link:
                self._drop("reconnecting", stop_stream=True)
            ns = argparse.Namespace(port=None, tcp=None, ble=False, ble_name=None)
            if link_kind == "usb":
                ns.port = target
            elif link_kind == "ble":
                ns.ble, ns.ble_name = True, target
            else:
                ns.tcp = target
            self.events.put(("status", "connecting to %s ..." % target))
            try:
                self.link = GuiLink(cli.open_io(ns), self.events)
            except Exception as e:   # bleak raises several types
                self.events.put(("disconnected", "cannot connect: %s" % e))
                return
            st = self.link.command("SESSION_UNLOCK", struct.pack("<I", cli.SESSION_KEY))
            hz = STREAM_HZ[link_kind]
            st_stream = self.link.command("GRIP_STREAM_EN", struct.pack("<H", hz))
            self.stream = st_stream == "OK"
            self.next_calib = 0.0
            mode = ("固件推送 %d Hz" % hz if self.stream else
                    "查询，最快 %.0f Hz（固件不支持推送：%s）" % (1.0 / POLL_S, st_stream))
            self.events.put(("connected", "%s %s (unlock %s)，数据：%s" % (link_kind.upper(), target, st, mode)))
        elif kind == "disconnect":
            self._drop("disconnected", stop_stream=True)
        elif kind == "op":
            _, label, name, args, quiet = item
            if not self.link:   # the GUI waits for this result before it sends the next slider move
                self.events.put(("result", label, "not connected", name, quiet))
                return
            st = self.link.command(name, args, timeout=3.0 if name == "MOTOR_SAVE_CONFIG" else 1.0)
            if st == "ERR_LOCKED":   # session relocked (e.g. after a reconnect): unlock and retry once
                self.link.command("SESSION_UNLOCK", struct.pack("<I", cli.SESSION_KEY))
                st = self.link.command(name, args)
            self.events.put(("result", label, st, name, quiet))
        elif kind == "scan":
            self.events.put(("scan", ble_scan()))

    def _request(self):
        """Ask for state, motor and both pads every POLL_S, but not before the
        last round has answered (or ROUND_TIMEOUT_S passed): a slow link then
        polls more slowly instead of piling up requests. Nothing waits here."""
        now = time.time()
        link = self.link
        if self.stream:   # the firmware pushes the rest
            if now >= self.next_calib or link.calib_wanted:
                self.next_calib = now + CALIB_S
                link.calib_wanted = False
                link.send(cli.OP["GRIP_GET_CALIB"])
            return
        if now < self.next_poll or (link.round_open and now - self.round_t < ROUND_TIMEOUT_S):
            return
        self.next_poll = now + POLL_S
        self.round_t = now
        link.round_open = True
        link.send(cli.OP["GRIP_GET_CALIB"])
        link.send(cli.OP["MOTOR_GET_STATUS"])
        link.send(cli.OP["HAPTIC_GET"])


def ble_scan():
    try:
        import asyncio
        from bleak import BleakScanner
        devs = asyncio.run(BleakScanner.discover(timeout=5.0))
    except Exception as e:
        return ["scan failed: %s" % e]
    return ["%s  %s" % (d.address, d.name) for d in devs if (d.name or "").startswith(cli.BLE_NAME)]


# GUI -------------------------------------------------------------------------

def run_gui(render_path=None) -> int:
    try:
        from PySide6.QtCore import QPointF, QRectF, Qt, QTimer
        from PySide6.QtGui import QColor, QFont, QFontDatabase, QKeySequence, QPainter, QPainterPath, QPen, QShortcut
        from PySide6.QtWidgets import (
            QApplication, QComboBox, QDoubleSpinBox, QFrame, QGridLayout, QHBoxLayout, QLabel,
            QLineEdit, QMainWindow, QPlainTextEdit, QPushButton, QSlider, QVBoxLayout, QWidget,
        )
        import serial.tools.list_ports
    except ImportError as exc:
        print(f"Missing GUI dependency: {exc}", file=sys.stderr)
        print("Install with: pip install -r host/requirements.txt", file=sys.stderr)
        return 1

    MUTED = QColor("#64748b")
    CYAN = QColor("#0284c7")
    ORANGE = QColor("#e56f00")
    GREEN = QColor("#07875c")
    RED = QColor("#d83a52")

    class Card(QFrame):
        def __init__(self, caption, color="#172033"):
            super().__init__()
            self.setObjectName("card")
            lay = QVBoxLayout(self)
            lay.setContentsMargins(10, 6, 10, 6)
            cap = QLabel(caption)
            cap.setObjectName("caption")
            self.value = QLabel("—")
            self.value.setStyleSheet(f"font-size: 15px; font-weight: 800; color: {color};")
            lay.addWidget(cap)
            lay.addWidget(self.value)

        def set(self, text):
            self.value.setText(text)

    class Plot(QWidget):
        """The last HISTORY_S seconds up to now. Each series keeps its own
        (time, value) samples, so one late reply leaves no hole in the others;
        a line breaks only at None or where samples are more than GAP_S apart."""

        def __init__(self, title, unit, series, fixed=None):
            super().__init__()
            self.title, self.unit, self.fixed = title, unit, fixed
            self.series = [(label, color, deque()) for label, color in series]
            self.empty_text = "等待数据"
            self.setMinimumHeight(170)

        def add(self, index, t, v):
            dq = self.series[index][2]
            dq.append((t, v))
            while dq and dq[0][0] < t - HISTORY_S - GAP_S:
                dq.popleft()

        def paintEvent(self, _e):
            p = QPainter(self)
            p.setRenderHint(QPainter.Antialiasing)
            p.fillRect(self.rect(), QColor("#fbfdff"))
            plot = QRectF(44, 24, self.width() - 56, self.height() - 42)
            p.setFont(QFont(UI_FONT, 8))
            fm = p.fontMetrics()
            p.setPen(MUTED)
            head = f"{self.title} ({self.unit})"
            p.drawText(QRectF(8, 3, 400, 18), Qt.AlignLeft, head)
            x = 8 + fm.horizontalAdvance(head) + 16
            for label, color, _ in self.series:
                p.fillRect(QRectF(x, 8, 8, 8), color)
                x += 12
                p.drawText(QRectF(x, 3, 200, 18), Qt.AlignLeft, label)
                x += fm.horizontalAdvance(label) + 14

            t1 = time.time()
            t0 = t1 - HISTORY_S
            vals = [v for _, _, dq in self.series for t, v in dq if v is not None and t >= t0]
            if self.fixed:
                lo, hi = self.fixed
                step = (hi - lo) / 4
            else:
                vmin = min(vals + [0.0])
                # a pad reads a few 0.1 N below zero after a tare: keep the axis at 0 for that
                lo, hi, step = nice_axis(vmin if vmin < -0.5 else 0.0, max(vals + [1.0]))
            # grid and value labels at round numbers
            n = int(round((hi - lo) / step))
            for i in range(n + 1):
                v = lo + i * step
                y = plot.bottom() - i / n * plot.height()
                p.setPen(QPen(QColor("#e1e8f0"), 1))
                p.drawLine(QPointF(plot.left(), y), QPointF(plot.right(), y))
                p.setPen(MUTED)
                p.drawText(QRectF(2, y - 8, 38, 16), Qt.AlignRight, f"{v:g}")
            for s in range(0, int(HISTORY_S) + 1, 5):   # time labels every 5 s
                xs = plot.right() - s / HISTORY_S * plot.width()
                align = Qt.AlignRight if s == 0 else (Qt.AlignLeft if s == HISTORY_S else Qt.AlignHCenter)
                box = QRectF(xs - (60 if s == 0 else 0 if s == HISTORY_S else 30), plot.bottom() + 3, 60, 14)
                p.drawText(box, align, "现在" if s == 0 else f"-{s} s")
            if not vals:
                p.drawText(plot, Qt.AlignCenter, self.empty_text)
                return

            p.setClipRect(plot.adjusted(-2, -2, 2, 2))
            for _, color, dq in self.series:
                path = QPainterPath()
                prev = None
                for t, v in dq:
                    if v is None:
                        prev = None
                        continue
                    x = plot.left() + (t - t0) / HISTORY_S * plot.width()
                    y = plot.bottom() - (min(max(v, lo), hi) - lo) / (hi - lo) * plot.height()
                    if prev is None or t - prev > GAP_S:
                        path.moveTo(x, y)
                    else:
                        path.lineTo(x, y)
                    prev = t
                pen = QPen(color, 2.2)
                pen.setCapStyle(Qt.RoundCap)
                pen.setJoinStyle(Qt.RoundJoin)
                p.setPen(pen)
                p.drawPath(path)

    def spin(lo, hi, value, step, decimals, suffix):
        s = QDoubleSpinBox()
        s.setRange(lo, hi)
        s.setValue(value)
        s.setSingleStep(step)
        s.setDecimals(decimals)
        s.setSuffix(suffix)
        return s

    class MainWindow(QMainWindow):
        def __init__(self):
            super().__init__()
            self.setWindowTitle("GripperOne 夹爪控制台")
            self.resize(1180, 760)
            self.events = queue.Queue()
            self.worker = Worker(self.events)
            self.worker.start()
            self.connected = False
            self.records = deque(maxlen=RECORD_MAX)
            self.last_c = None       # latest GRIP_GET_CALIB reply, for refusal hints
            self.last_m = None       # latest motor status (None: no motor feedback)
            self.last_m_t = 0.0      # when it arrived
            self.m_stale = False     # "no feedback" shown
            self.last_pads = {}      # pad index -> latest Fz (N)
            self.connected_t = 0.0
            self.cal_run = None      # home / calibration in progress: {"label", "t0", "seen"}
            self.why_pending = False # home / calibration refused: report the fault from the next poll
            self.live_pct = None     # dragged slider: newest closing percent not sent yet
            self.live_busy = False   # a slider move is in flight
            self.live_t = 0.0        # when the last slider move was sent
            self.live_err = ""       # last slider refusal logged, so a drag logs it once
            self._syncing = False    # slider and spin box updating each other, not the user

            root = QWidget()
            self.setCentralWidget(root)
            outer = QVBoxLayout(root)
            outer.setContentsMargins(14, 10, 14, 10)

            # connection bar
            bar = QHBoxLayout()
            title = QLabel("GripperOne 夹爪控制台")
            title.setObjectName("title")
            bar.addWidget(title)
            bar.addStretch(1)
            self.kind = QComboBox()
            self.kind.addItem("USB", "usb")
            self.kind.addItem("蓝牙", "ble")
            self.kind.addItem("Wi-Fi", "tcp")
            self.kind.currentIndexChanged.connect(self._kind_changed)
            self.target = QComboBox()
            self.target.setEditable(True)
            self.target.setMinimumWidth(260)
            self.refresh = QPushButton("刷新")
            self.refresh.clicked.connect(self._refresh_targets)
            self.connect_btn = QPushButton("连接")
            self.connect_btn.setObjectName("primary")
            self.connect_btn.clicked.connect(self._toggle_connect)
            self.status = QLabel("● 未连接")
            self.status.setObjectName("off")
            for w in (self.kind, self.target, self.refresh, self.connect_btn, self.status):
                bar.addWidget(w)
            outer.addLayout(bar)

            body = QHBoxLayout()
            outer.addLayout(body, 1)

            # operations
            ops = QFrame()
            ops.setObjectName("panel")
            ops.setFixedWidth(360)
            ol = QVBoxLayout(ops)
            ol.addWidget(self._section("准备"))
            row = QHBoxLayout()
            self.btn_home = self._op_button("原点检查 home", lambda: self._op("原点检查", "GRIP_HOME"), motion=True)
            self.btn_cal = self._op_button("完整标定", lambda: self._op("完整标定", "GRIP_CALIBRATE"), motion=True)
            row.addWidget(self.btn_home)
            row.addWidget(self.btn_cal)
            ol.addLayout(row)
            hint = QLabel("home / 标定时两垫之间必须空着")
            hint.setObjectName("caption")
            ol.addWidget(hint)
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
