alfredzhang98/GripperOne/(commit log)

2026-07-07 Add user protocol layer, gripper app, tactile GUI; multi-agent review fixes
    Firmware:
    - app_protocol: framed/CRC16 user protocol (app_proto) shared by BLE + Wi-Fi;
    opcode set for system/motor/imu/haptic/gripper, session-unlock gating.
    - gripper: high-level app layer — auto range calibration (stall to hard stops,
    NVS-persisted closed/open zero), position moves, tactile force-closed-loop
    grip, state machine; supervisor dispatches + ticks it.
    - Real protocol codecs verified against source_files: PaXini 通信盒 haptic
    (0xAA56 auto-push, LRC), WitMotion JY901P IMU, Damiao DM-J4310 MIT-mode TWAI.
    - Review fixes: IMU parser heap overflow, gripper crush/runaway + degenerate
    calibration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
2026-07-07 Bench motor bring-up, BLE/tactile tools, protocol & safety fixes
    - supervisor: sensor-liveness watchdog only faults on a sensor that streamed
    and then went silent, never on one never present -> motor is bench-testable
    standalone (no haptic/IMU) without being kicked to SAFE_STOP.
    - BLE: request MTU for the largest frame AND fragment notifications by the
    negotiated MTU so haptic telemetry works at any MTU; guard s_last_tx with a
    spinlock against the GATT-read race.
    - motor_twai: filter RX strictly on MST_ID so foreign bus traffic can't be
    mis-decoded as feedback; ESC/MST IDs configurable via cfg.
    - Over-force SAFE_STOP cutoff (per-module peak Fz), was a TODO.
    - Task stack/p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
2026-07-15 IMU: roll/pitch + accel/gyro with auto gravity removal; unified app_proto transport (default UART); drop OLED & web frontends
    IMU (JY901P), reworked around what's useful next to the arm/motors:
    - Sample carries roll/pitch (no yaw), raw accel, gravity-removed lin_accel,
    gyro, temp. Gravity is estimated by low-pass on raw accel (auto, orientation-
    and sign-agnostic), leaving linear accel ~0 at rest for vibration/impact.
    - Parse ACC(0x51)/GYRO(0x52)/ANGLE(0x53); publish once per output burst.
    - Full WIT register map in wit_reg.h (private) with R/RW tags.
    - Complete low-level driver (SDK replacement): write_reg (auto-unlock),
    accel/angle-ref/yaw-zero/mag/gyro calibrations run as non-blocki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
2026-07-28 update the gripper
2026-10-23 Gripper control verified on the bench: calibration, home, fast moves, force grip
    - Calibration finds the opening end by torque (0.36 N*m) and the closed end
    by tactile contact; results are stored in NVS. GRIP_HOME re-finds the pad
    touch after power-up and keeps the stored calibration if an object is in
    the way.
    - Moves within 5..95 % closing at 0.05..15 rad/s (default 2). The drive's
    ACC/DEC (+-80 rad/s^2) and KP_APR (108) are written at every probe; current
    limits rise only when the motion needs more and a blocked jaw stops.
    - Force grip 0.5..20 N on the larger pad reading: friction measured on the
    approach, ceiling 1.5 x friction + margin with automatic raise, faster
    unloadin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
2026-10-23 Bluetooth and Wi-Fi control, GUI control panel, user manual
    - Transports run side by side (USB always, BLE on, Wi-Fi implemented but
    off via APP_ENABLE_WIFI): each link has its own reply sink, telemetry goes
    only to the links that enabled it, and each link unlocks its own session.
    A link that disconnects is relocked; a move it started stops, a grip keeps
    holding.
    - Wi-Fi: own access point GripperPlus-XXXX (192.168.4.1, TCP 5000) plus an
    optional stored network (OP_WIFI_SET_STA 0x09, OP_WIFI_GET_INFO 0x0A).
    - BLE: per-link sink and relock on disconnect; NimBLE notify logging muted.
    - Large single-app partition table (1.5 MB app); nvs offset unchanged, so a
    stored calibration survi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
2026-10-27 Split into hardware/firmware, bilingual docs, full BOM
    - Move the ESP-IDF project into firmware/; add hardware/ with SolidWorks
    CAD (Git LFS), Altium PCB sources and production files, datasheets,
    and wiring notes (incl. the USB vs DC-DC power conflict).
    - Every document now has a Chinese (X.md) and English (X.en.md) version;
    the old root README is split into firmware/README, hardware/WIRING and
    docs/PROTOCOL. README_gripper.md becomes docs/GRIPPER_CONTROL.md.
    - New BOM (BOM.xlsx + BOM.md/.en.md): structural parts with clean CAD
    renders and process (PETG print / CNC), drive train, bearings,
    fasteners, motor and all electronics with purchase links and images,
    PCB component list,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
2026-10-27 Add gripper demo GIF and video to the README
    The clip is the bench video with the background removed (SAM 2.1
    tracking, white background); the MP4 keeps the original audio.
2026-10-27 Rename PCB to gripper_control, add production files and PX-6AX datasheets
2026-10-27 Add GPL-3.0 license, Douyin video link, and IMU purpose
